screinac/controlador-de-aforo/EsquemaSugerenciasProfe.odp

Cuántas personas hay?

Wifi

OMS

2 personas por m2

FT232RL

Qué debo hacer?

uart

Pensa caja cómo sostiene

y soldadura superficial

Tarjeta SD

Parlante

Pines spi o uart

Esp32

Indicador encendido

dac

2 Sensores proximidad

(ultrasondio)

pwm

Led RGB

Qué tan lleno esta?

Hay que usar tapabocas?

Que el audio se pueda cambiar por la app

Salida

Entrada

Va conectado a la corriente

Abrir y cerrar puerta (motor)

Ventiladores

LCD con cuanta gente hay

RFID

APP
