screinac/controlador-de-aforo/Esquema.odp

Wifi

1 personas por m2

OMS

Cuántas personas hay?

Qué debo hacer?

Reproductor mp3 (dfplayer)

Parlante

Esp8266

Ventiladores

2 Sensores proximidad

(ultrasondio)

Led RGB

Qué tan lleno esta?

Hay que usar tapabocas?

Que el audio se pueda cambiar por la app

Salida

Entrada

LCD con cuanta gente hay

RFID

Abrir y cerrar puerta (motor)

APP
