screinac/controlador-de-aforo/Imagenes/ControladorAforo-Final5.jpeg

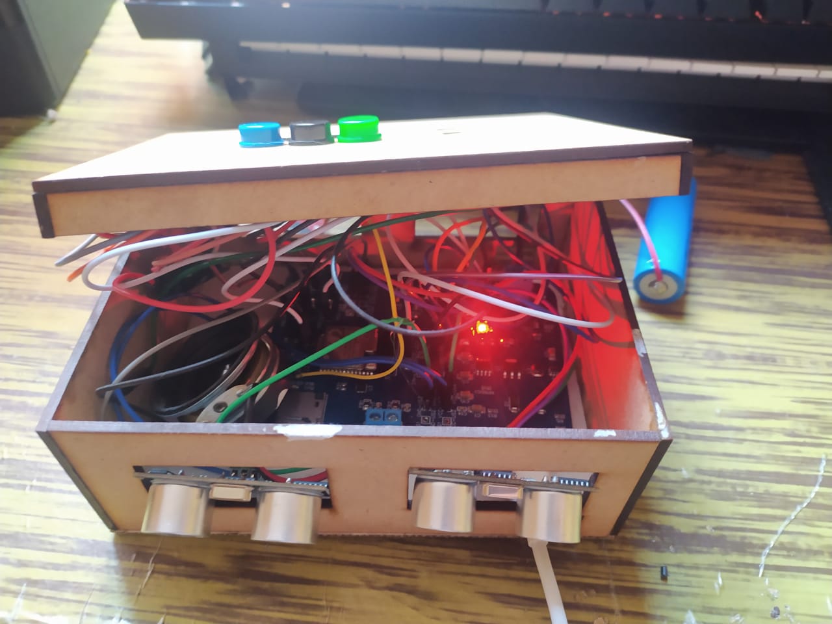
Imagenes/ControladorAforo-Final5.jpeg
