screinac/controlador-de-aforo/Imagenes/Esquema-Controlador-de-Aforo.png

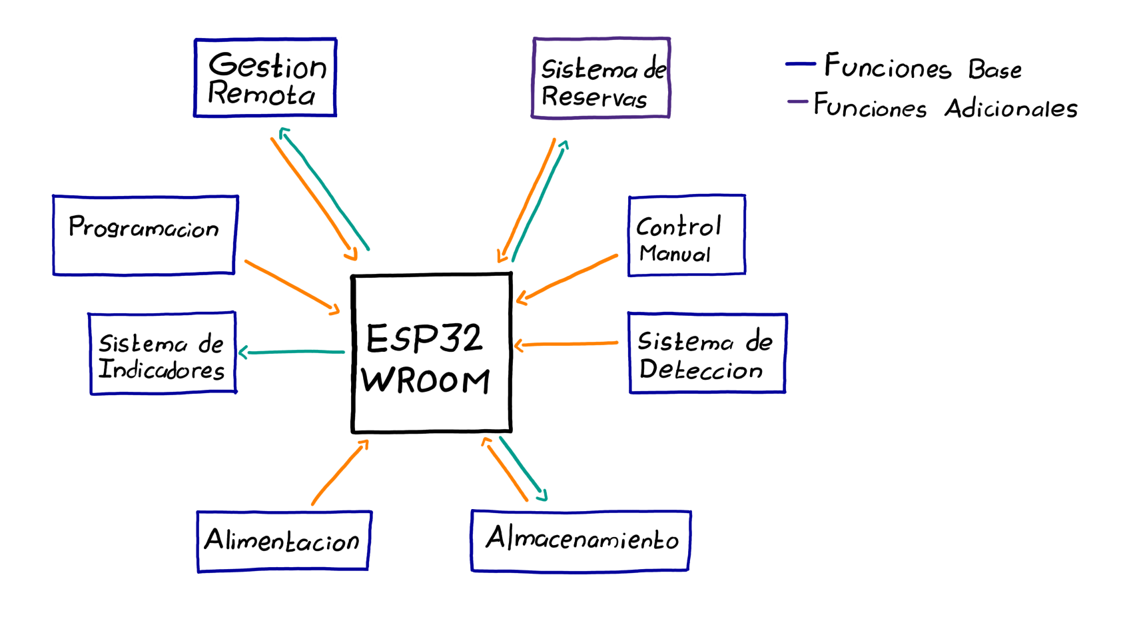
Imagenes/Esquema-Controlador-de-Aforo.png
