screinac/controlador-de-aforo/Imagenes/KiCAD-Esquema-Programador.png

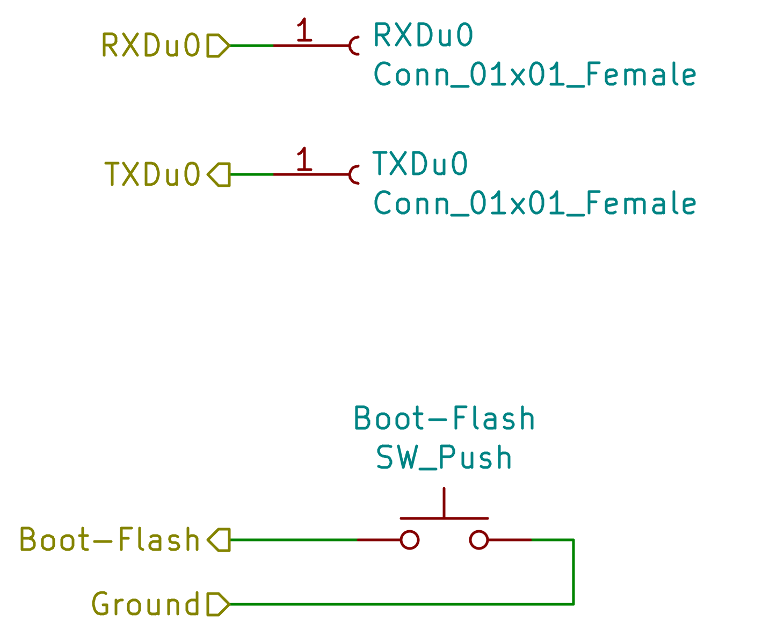
Imagenes/KiCAD-Esquema-Programador.png
