screinac/controlador-de-aforo/EasyEDa - Controlador Aforo/BOM_PCB_Controlador_aforo_2022-01-13.csv

ID | Name | Designator | Footprint | Quantity | Manufacturer Part | Manufacturer | Supplier | Supplier Part | Price | Pins | 3DModel | JLCPCB Part Class | LCSC Assembly | Contributor | image | license | link
1 | 1K | R1,R2,R5,R19 | R0603 | 4 | ERJP03J102V | PANASONIC | LCSC | C427272 | 0.043 | 2 | R0603_L1.6-W0.8-H0.8 |  |  | LCSC |  |  | https://www.mouser.in/datasheet/2/447/PYu_RT_1_to_0_01_RoHS_L_11-1669912.pdf
2 | LED0603B-RED | CHARGELED | LED0603-RD | 1 | LED0603B | null | LCSC | C9900005354 |  | 2 | LED0603_Green | Extended Part |  | LCSC |  |  | https://item.szlcsc.com/347874.html
3 | LED0603B-BLUE | FLASHLED,SDLED | LED0603-RD | 2 | LED0603B | null | LCSC | C9900005354 |  | 2 | LED0603_Green | Extended Part |  | LCSC |  |  | https://item.szlcsc.com/347874.html
4 | LED0603B-GREEN | STDBYLED | LED0603-RD | 1 | LED0603B | null | LCSC | C9900005354 |  | 2 | LED0603_Green | Extended Part |  | LCSC |  |  | https://item.szlcsc.com/347874.html
5 | 10K | R3,R7,R10,R12,R13 | R0603 | 5 | RC0603FR-0710KL | YAGEO | LCSC | C98220 | 0.001 | 2 | R0603_L1.6-W0.8-H0.8 | Extended Part |  | 立创EDA官方封装库 |  |  | https://www.mouser.in/datasheet/2/447/PYu_RT_1_to_0_01_RoHS_L_11-1669912.pdf
6 | 220pF | C9,C16,C17 | C0603 | 3 | HGC0603R7221K500NTHJ | Chinocera | LCSC | C482474 | 0.004 | 2 | C0603_L1.6-W0.8-H0.8 |  |  | LCSC |  |  | https://item.szlcsc.com/362304.html
7 | GT-TC089B-H043-L1 | BOOT,ENABLE1 | SW-SMD_4P-L6.0-W6.0-P4.50-LS8.5 | 2 | GT-TC089B-H043-L1 | G-Switch | LCSC | C843624 | 0.052 | 4 | SW-SMD_4P-L6.0-W6.0-P4.50-LS8.5 | Extended Part |  | LCSC |  |  | https://item.szlcsc.com/832478.html
8 | 100nF | C2,C12,C14,C7 | C0603 | 4 | CS1608X7R225K100NRB | Samwha Capacitor | LCSC | C516003 | 0.012 | 2 | C0603_L1.6-W0.8-H0.8 |  |  | LCSC |  |  | https://item.szlcsc.com/362304.html
9 | RB161L-40TE25 | D1,D2 | SMA_L4.5-W2.6-LS5.0-RD | 2 | RB161L-40TE25 | ROHM Semicon | LCSC | C703625 | 0.165 | 2 | SMA_L4.5-W2.6-LS5.0-RD | Extended Part |  | LCSC |  |  | https://atta.szlcsc.com/upload/public/pdf/source/20200709/C698948_1D2872B6684CFFE3126D379DF4068CF0.pdf
10 | 100 | R4,R8,R9,R11,R15 | R1206 | 5 | CR1206J40101G | LIZ | LCSC | C102267 | 0.003 | 2 | R1206_L3.2-W1.6-H0.6 | Extended Part |  | layout |  |  | https://item.szlcsc.com/311874.html
11 | 7.5K | R6 | R0603 | 1 | AECR0603F7K50K9 | ResistorToday | LCSC | C328377 | 0.003 | 2 | R0603_L1.6-W0.8-H0.8 |  |  | LCSC |  |  | https://www.mouser.in/datasheet/2/447/PYu_RT_1_to_0_01_RoHS_L_11-1669912.pdf
12 | 180 | R14,R18 | R0603 | 2 | AECR0603F180RK9 | ResistorToday | LCSC | C352360 | 0.003 | 2 | R0603_L1.6-W0.8-H0.8 |  |  | LCSC |  |  | https://www.mouser.in/datasheet/2/447/PYu_RT_1_to_0_01_RoHS_L_11-1669912.pdf
13 | 4.7K | R16,R17 | R1206 | 2 | RMC12064.7K5%N | Tyohm | LCSC | C269760 | 0.007 | 2 | R1206_L3.2-W1.6-H0.6 | Extended Part |  | LCSC |  |  | https://item.szlcsc.com/311874.html
14 | 100K | R21 | R0603 | 1 | RC0603FR-07100KL | YAGEO | LCSC | C14675 | 0.001 | 2 | R0603_L1.6-W0.8-H0.8 | Extended Part |  | LCSC |  |  | https://www.mouser.in/datasheet/2/447/PYu_RT_1_to_0_01_RoHS_L_11-1669912.pdf
15 | 1.2K | RPROG1 | R0603 | 1 | CR0603JA0122G | LIZ | LCSC | C101265 | 0.001 | 2 | R0603_L1.6-W0.8-H0.8 | Extended Part |  | 立创EDA官方封装库 |  |  | https://www.mouser.in/datasheet/2/447/PYu_RT_1_to_0_01_RoHS_L_11-1669912.pdf
16 | XY300V-A-5.0-2P | BATTERY,SPEAKER | CONN-TH_XY300V-A-5.0-2P | 2 | XY300V-A-5.0-2P | -- | LCSC | C557648 | 0.095 | 2 | CONN-TH_XY300V-A-5.0-2P | Extended Part |  | LCSC |  |  | https://atta.szlcsc.com/upload/public/pdf/source/20200527/C557648_4A2FA4132AA24EE423B62B1474E9B5BB.pdf
17 | 10uF | C1,C3,C4,C5,C6,C8,C13,C15 | C1206 | 8 | CL31A106KBHNNNE | SAMSUNG | LCSC | C13585 | 0.036 | 2 | C1206_L3.2-W1.6-H1.3 | Basic Part |  | layout |  |  | https://item.szlcsc.com/89171.html
18 | DM3CS-SF | TF1 | TF-SMD_DM3CS-SF | 1 | DM3CS-SF | Hirose | LCSC | C202111 | 1.134 | 13 | TF-SMD_DM3CS-SF | Extended Part |  | LCSC |  |  | https://item.szlcsc.com/203288.html
19 | HDR-M-2.54_1x1 | 3.3V,5V,BTNC1,BTNC2,BTNC3,GND-BTNC1,GND-BTNC2,GND-BTNC3,GND_1,GND_2,GPIO,SCL,SDA,CGROUND,DIN-LED1,DIN-LED2,DOUT-LED1,ECHO-US1,ECHO-US2,ECHO-US3,ECHO-US4,GND-LED1,GND-LED2,GND-US1,GND-US2,GND-US3,GND-US4,RX,TRIG-US1,TRIG-US2,TRIG-US3,TRIG-US4,TX,VCC-LED1,VCC-LED2,VCC-US1,VCC-US2,VCC-US3,VCC-US4 | HDR-M-2.54_1X1 | 39 |  |  | LCSC | C81276 | 0.005 | 1 | HDR-M-2.54_1x1 |  |  | LCEDA_Lib
20 | 47Ω | FB1,FB2 | 0805 | 2 | BK2125HS470-T | TAIYO YUDEN | LCSC | C92871 | 0.048 | 2 | Taiyo Yuden UMK212BJ104KG-T |  |  | SparkFun
21 | 6.8uH | L3 | IND-SMD_L3.5-W3.0 | 1 | SCCD32-6R8MT | Yanchuang | LCSC | C532852 | 0.028 | 2 | IND-SMD_L3.5-W3.0-H2.0 | Extended Part |  | LCSC |  |  | https://item.szlcsc.com/392683.html
22 | FS8205A | Q1 | TSSOP-8_3X4.4X065P | 1 | FS8205A | FORTUNE | LCSC | C16052 | 0.192 | 8 | FS8205A |  | Yes | alehramanovich | //image.lceda.cn/szlcsc/C16052.jpg
23 | NTF6P02T3G | Q3 | SOT-223-4_L6.5-W3.5-P2.30-LS7.0-BR | 1 | NTF6P02T3G | VBsemi Elec | LCSC | C558214 | 0.385 | 4 | SOT-223-4P_L6.5-W3.5-H1.6-LS7.0-P2.30 | Extended Part |  | 立创EDA官方封装库 |  |  | https://item.szlcsc.com/84517.html
24 | ESP32-S | U1 | WIRELM-SMD_ESP32-S | 1 | ESP32-S | Ai-Thinker | LCSC | C277944 | 4.248 | 39 | WIRELM-SMD_L25.5-W18.0-H2.8-ESP32-S | Extended Part |  | 立创EDA官方封装库 |  |  | https://lcsc.com/product-detail/Others_Ai-Thinker-ESP32-S_C277944.html
25 | TP4056 | U2 | ESOP-8_L4.9-W3.9-P1.27-LS6.0-BL-EP | 1 | TP4056 | TOPPOWER | LCSC | C16581 | 0.203 | 9 | ESOP-8_L4.9-W3.9-H1.6-LS6.0-P1.27 | Basic Part |  | LCSC |  |  | https://www.mornsun.cn/html/pdf/SCM1501B.html
26 | MAX98357AETE+T | U3 | TQFN-16_L3.0-W3.0-P0.50-BL-EP1.5 | 1 | MAX98357AETE+T | MAXIM(美信) | LCSC | C910544 | 1.805 | 17 | TQFN-16_L3.0-W3.0-H0.8-P0.50 | Extended Part |  | LCSC |  |  | https://item.szlcsc.com/533528.html
27 | MT3608 | U4 | SOT-23-6_L2.9-W1.6-P0.95-LS2.8-BR | 1 | MT3608 | AEROSEMI | LCSC | C84817 | 0.178 | 6 | SOT-23-6_L2.9-W1.6-H1.5-LS2.8-P0.95 | Extended Part |  | 87804271zpf |  |  | https://item.szlcsc.com/169042.html
28 | DW01A-G | U7 | SOT-23-6_L2.9-W1.6-P0.95-LS2.8-BR | 1 | DW01A-G | FORTUNE | LCSC | C61503 | 0.107 | 6 | SOT-23-6_L2.9-W1.6-H1.5-LS2.8-P0.95 | Extended Part |  | 87804271zpf |  |  | https://item.szlcsc.com/169042.html
29 | AMS1117-3.3 | U9 | SOT-223 | 1 | AMS1117-3.3 | AMS | LCSC | C6186 | 0.149 | 4 | ams1117-3.3v |  | Yes | LCSC | //image.lceda.cn/szlcsc/C6186.jpg | https://www.gnu.org/licenses/lgpl-2.1.html
30 | TYPE-C-31-M-16 | USB-C | TYPE-C-SMD_TYPE-C-31-M-16 | 1 | TYPE-C-31-M-16 | Korean Hroparts Elec | LCSC | C283541 | 0.318 | 10 | TYPE-C-SMD_6P-L8.9-W6.8-H3.2-P1.00 | Extended Part |  | 立创EDA官方封装库 |  |  | https://item.szlcsc.com/269352.html
