screinac/controlador-de-aforo/(list of files, drawings)

Other design files:
EasyEDa - Controlador Aforo/Controlador Aforo.json
