screinac/controlador-de-aforo/(commit log)

2021-10-21 se agregan la idea 11 y 12
2021-11-16 Adicion de Imagen
2021-11-17 Actualizacion ESP32
2021-12-26 Actualizacion Documentacion - Diseño Esquematico
    [Controlador Aforo.json, Controlador de Aforo.kicad_pcb, Controlador de Aforo.sch, Programador.sch]
2021-12-27 Esquematico Completo - Documentacion Diseño
    [Controlador Aforo.json]
2022-01-13 Seccion PCB
    [BOM_PCB_Controlador_aforo_2021-12-29.csv, Controlador Aforo.json, PickAndPlace_PCB_Controlador_aforo_2021-12-29.csv]
2022-01-24 Inicio de Programacion
    [BOM_PCB_Controlador_aforo_2021-12-29.csv, BOM_PCB_Controlador_aforo_2022-01-13.csv, Componentes Basicos JLCPCB.xlsx, Controlador Aforo.json, PickAndPlace_PCB_Controlador_aforo_2021-12-29.csv, PickAndPlace_PCB_Controlador_aforo_2022-01-13.csv]
2022-01-24 Actualizacion Imagenes
    [Controlador Aforo.json]
2022-01-26 Documentacion modulo de Audio
2022-02-02 Main Code sin Wifi
    [config.txt]
2022-02-02 copia de seguridad configuracion
    [config (copia).txt]
